paclema/3dprinterDesings/README.md

# 3dprinterDesings
Desings and upgrades for 3d printers

* Filament run out sensor

Author & license  
--
Author: Pablo Clemente 
License: CC-BY-SA (<http://creativecommons.org/licenses/by-sa/4.0/>)
