paclema/3dprinterDesings/Filament_runout/README.md

# Filament run out sensor
This allows Marlin to know when there isn't filament for extrude. Marlin pauses the sd card printing and wait for use to restart.
It is made for any 3d printer of 1,75 filament.
Tested on RAMPS 1.4
