paclema/3dprinterDesings/Filament_runout/IN-Filamentrunout-210515-1559-142.pdf

1.

# Filament run out

Se ha preparado un sencillo dispositivo para detectar el final de una bobina de plástico. Este es un ejemplo (https://www.youtube.com/watch?v=L lDzVuqXmHc): (https://www.youtube.com/watch?v=LlDzVuqXmHc)

Los commits han sido mergeados en el firmware oficial de marlin mediaante los siguientes pull requests:

https://github.com/MarlinFirmware/Marlin/pull/1998https://github.com/MarlinFirmware/Marlin/pull/1999

# Firmware:

El firmware para la witbox está preparado en:

https://github.com/paclema/Marlin/tree/Witbox_Array

La configuración para una witbox se encuentra ya configurada en la carpeta de configuraciones del repositorio para dicha máquina.

La ultima versión compilada para el array es esta: Marlin.Array.Filrunout.hex (https://confluence.bq.com/download/attachments/48334050/Marlin.Array.Filrunout.hex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) que corresponde al commit ba4c16ee1d0 (21-05-2015)

# Hardware:

Piezas necesarias:

Endstop de witbox/hephestos:
Cable para endstop (el más largo de la witbox):
Pieza impresa: https://github.com/paclema/3dprinterDesings/tree/master/Filament_runout
2 tornillos M3x6 gota sebo

Para la implementación en una Witbox (o en una prusa con RAMPS) se han de seguir los siguientes pasos:

Montar el endstop en la pieza impresa:

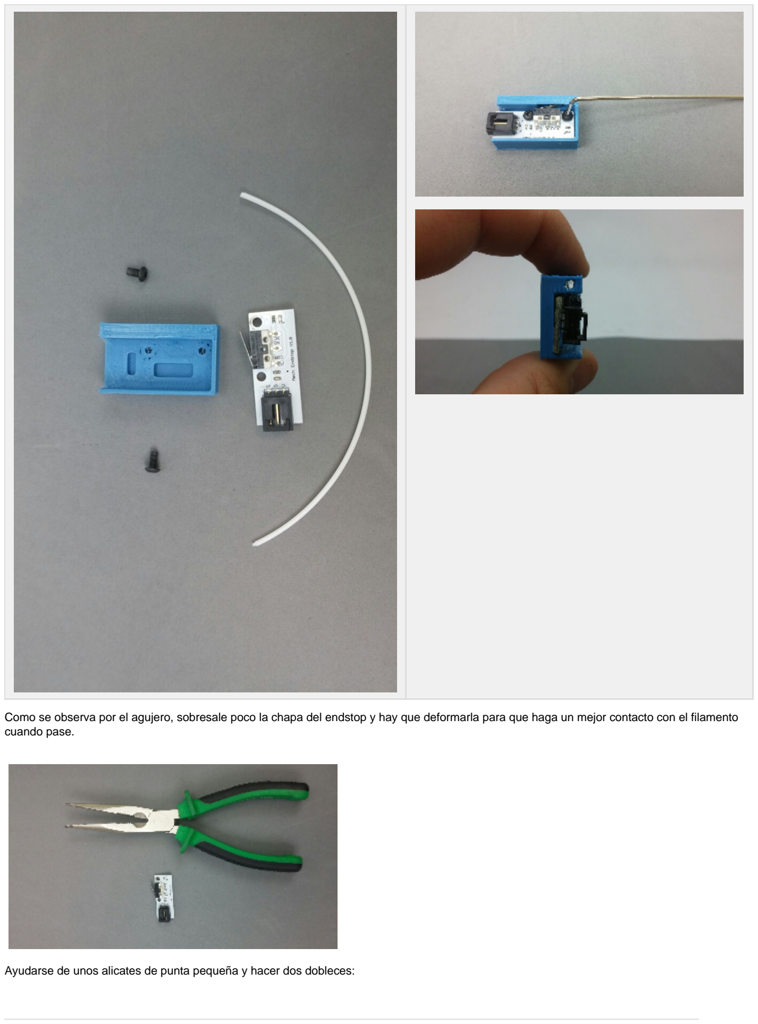
[picture p1: page 2]

Como se observa por el agujero, sobresale poco la chapa del endstop y hay que deformarla para que haga un mejor contacto con el filamento cuando pase.

Ayudarse de unos alicates de punta pequeña y hacer dos dobleces:

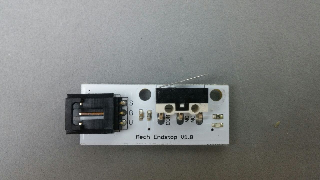
[picture p2: figure]
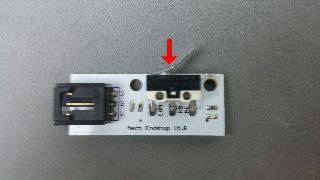
[picture p3: figure]
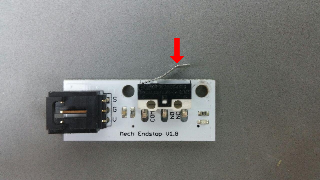
[picture p4: figure]

Comprobamos que la chapa del endstop sobresale más en el interior del agujero:

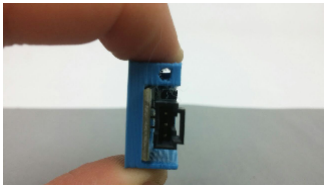
[picture p5: figure]

Ahora preparamos un cable de final de carrera (cable endstop eje Z ó Y de witbox)

¡¡ATENCIÓN!! es importante tener en cuenta la polaridad de los cables:

En la parte del endstop lo dejamos igual
En el conector que va a la RAMPS intercambiamos GND por 5V
Endstop | RAMPS
BLUE | BLUE
BLACK | RED
RED | BLACK

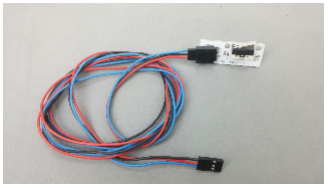
[picture p6: figure]

Para poder utilizar la via de 5 voltios necesitamos introducir un jumpeer entre Vin y 5v, en los pines de la derecha del botón de reset.

De la fila de 3 pines lo conectamos en los dos del interior de la placa, los de más abajo en la imagen.

Podemos encontrar algún jumper debajo del driver para el segundo extrusor de la RAMPS, que no se están utilizando.

El conector del sensor lo conectamos en el pin digital 4, el más alejado del botón de reset a la izquierda en el primer bloque auxiliar de pines

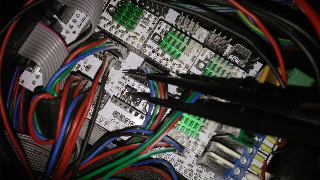
[picture p7: figure]
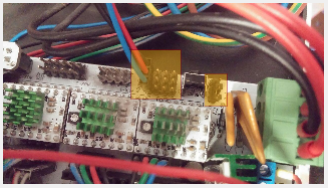
[picture p8: figure]

Comprobamos que el sensor detecta bien el filamento en cualquierposición, sino ajustamos los dobleces de la pletina:

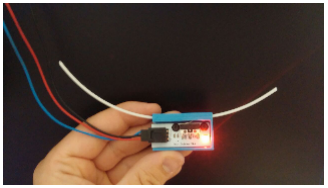
[picture p9: figure]

Llevamos el cable junto a la fuente de alimentación junto con el cable del final de carrera del eje Z y lo sacamos por el orificio del forex de esta forma:

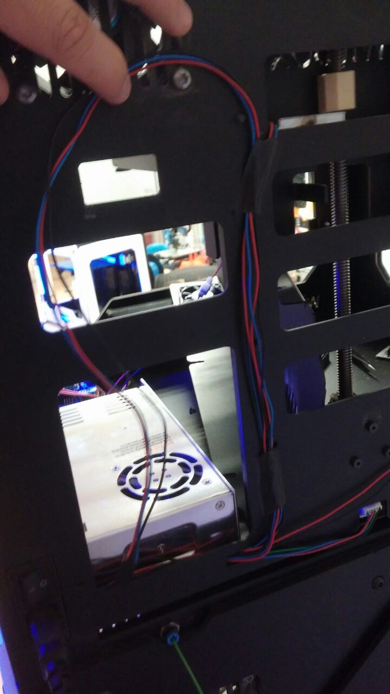
[picture p10: figure]
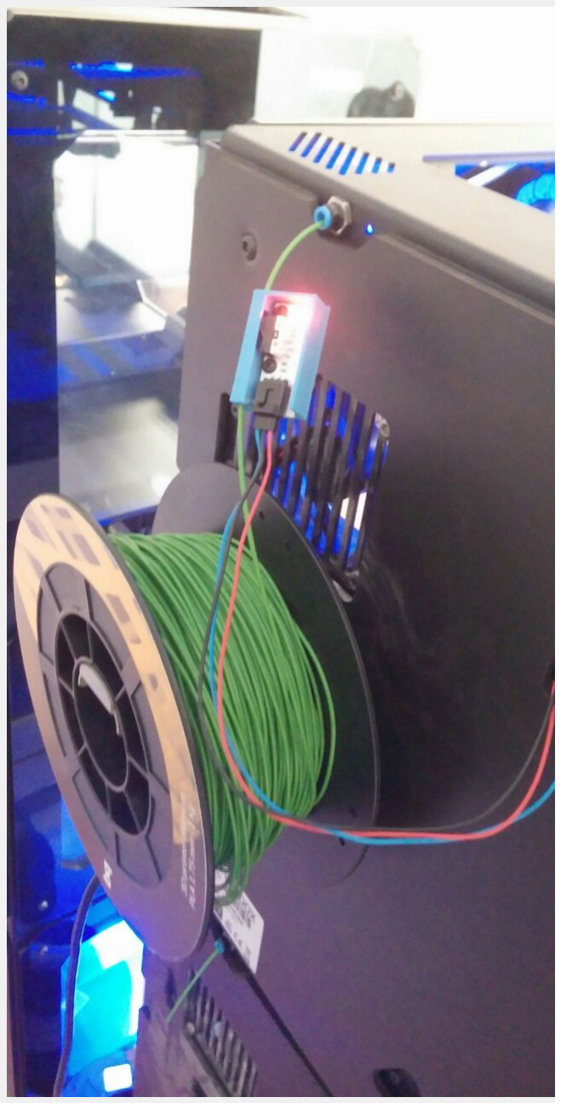
[picture p11: figure]

Adicionalmente, se puede añadir un trozo de teflón entre el sensor y la entrada del filamento en la witbox, para evitar que se produzca un giro brusco en esa zona en el filamento.

De esta forma, solo cuando estemos imprimiendo mediante SD,si se deja de detectar el filamento, la impresora posicionará el cabezal en un lateral y parpadeará la luz azul de la witbox, ejecutando un "wait for user...", posteriormente cuando se pulse el encoder, se ejecuta un cambio automático del filamento y se reanuda la impresión.
