paclema/3dprinterDesings/Filament_runout/filament_endstop_cover - copia.FCStd

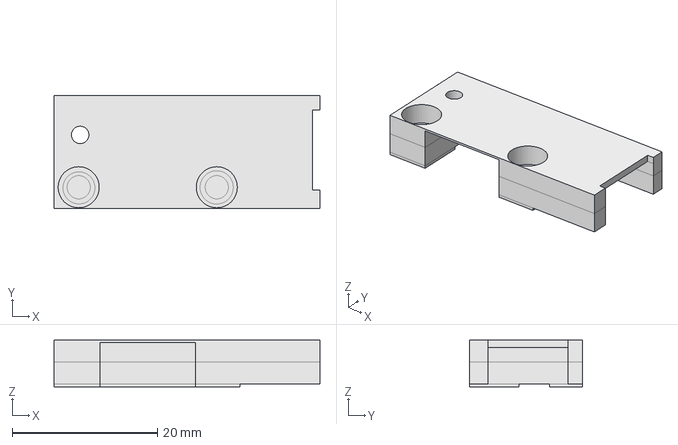
[picture p13: CAD file, 2015-08-02]
Filament_runout/filament_endstop_cover - copia.FCStd
36.6 x 15.5 x 6.40 mm
