paclema/3dprinterDesings/Filament_runout/Base_endstop.stl

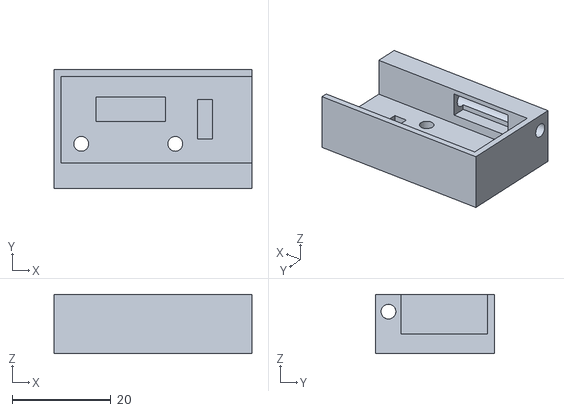
[picture p14: CAD file, 2015-05-20]
Filament_runout/Base_endstop.stl
40.0 x 24.0 x 12.0
