paclema/3dprinterDesings/Filament_runout/Base_endstop_witExtruder.stl

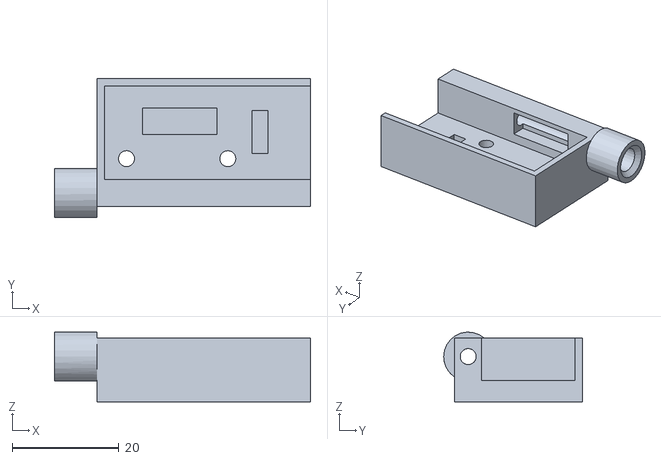
[picture p15: CAD file, 2015-05-20]
Filament_runout/Base_endstop_witExtruder.stl
48.0 x 26.0 x 13.1
