paclema/3dprinterDesings/(list of files, cad)

Other CAD files:
Filament_runout/Base_endstop_cover2.stl
Filament_runout/Base_endstop_cover.stl
Filament_runout/filament_endstop.FCStd
Filament_runout/filament_endstop_witExtruder.FCStd
