paclema/3dprinterDesings/(commit log)

2015-05-20 Added Filament run out sensor desing
    [Base_endstop.stl, Base_endstop_witExtruder.stl, filament_endstop.FCStd, filament_endstop_witExtruder.FCStd]
2015-05-21 Updated filament runout instructions
2015-05-24 Added filament run out cover design
    [Base_endstop_cover.stl, filament_endstop_cover.FCStd]
2015-08-02 Updated v2 cover for filament runout
    [Base_endstop_cover2.stl, filament_endstop_cover - copia.FCStd, filament_endstop_cover2.FCStd]
